SauleVire/Kolektorius_v2a/v1.2/Order#100022604_2Layer_Green_1.6mm_HASL_5cm_x_5cm.TXT

%
M48
M72
T01C0.0120
T02C0.0320
T03C0.0394
T04C0.0400
T05C0.1102
T06C0.1180
T07C0.1181
T08C0.1260
%
T01
X9660Y8633
X13950Y8253
X10000Y15043
X14640Y8623
X13690Y10073
T02
X4600Y7633
X4600Y3633
X5600Y3633
X5600Y7633
X6600Y7633
X6600Y3633
X7600Y7633
X7600Y3633
X2100Y15633
X2600Y14883
X3100Y15633
X12600Y7633
X12600Y11633
X10600Y10633
X10600Y14633
X10850Y17383
X6850Y17383
X6850Y16383
X10850Y16383
X10850Y15383
X6850Y15383
T03
X3100Y16883
X4100Y16883
X5100Y16883
X10600Y19633
X11600Y19633
X12600Y19633
X6600Y19633
X7600Y19633
X8600Y19633
X2600Y19633
X3600Y19633
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
