SauleVire/Kolektorius_v2a/v.2/kolektorius_v2.pdf

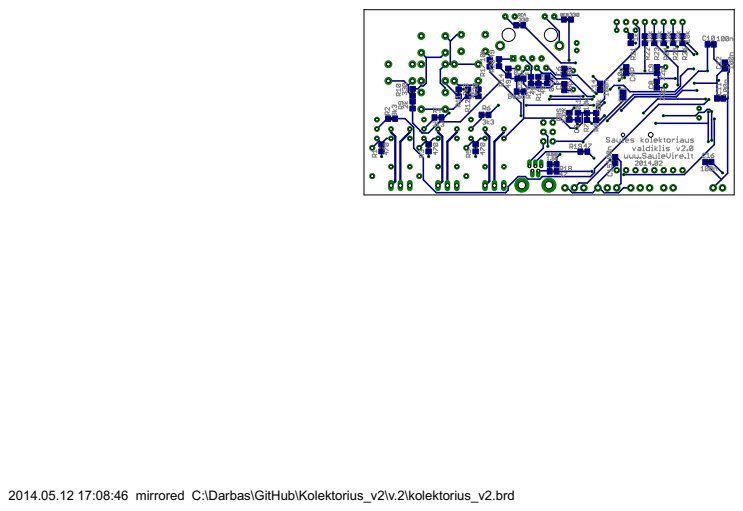
[picture p1: page 1]

2014.05.12 17:08:46 mirrored C:\Darbas\GitHub\Kolektorius_v2\v.2\kolektorius_v2.brd
