SauleVire/Kolektorius_v2a/(list of files, drawings)

Other design files:
skv_v12-arduino-pro-mini-1.fzz
