SauleVire/Kolektorius_v2a/v1.21_hardware/solar_collector_controller_V1.21.brd

## EAGLE design v1.21_hardware/solar_collector_controller_V1.21.brd (2014-10-30)

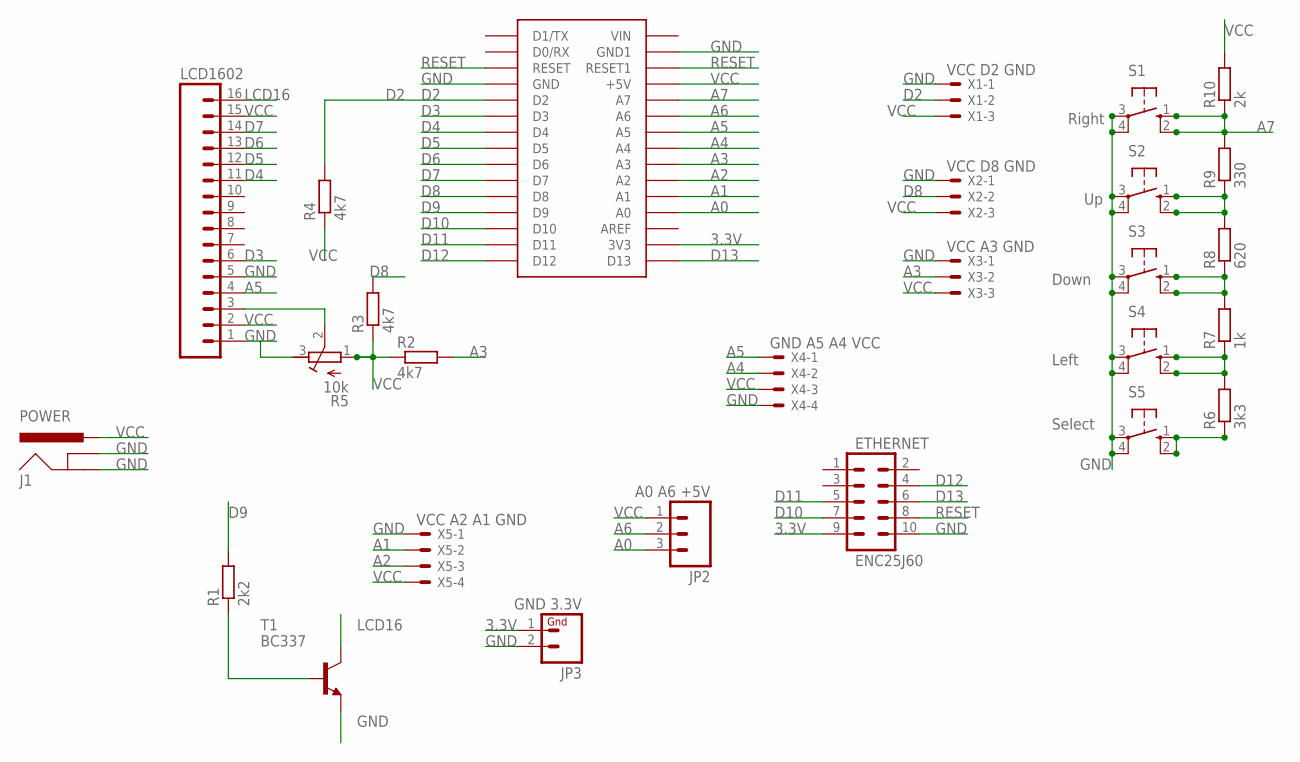
[picture p2: schematic solar_collector_controller_V1.21.sch]

Parts:
ETHERNET: ENC25J60; AVR_ICSP
J1: POWER; POWER_JACK_PTH_LOCK
JP2: A0 A6 +5V; 1X03
JP3: GND 3.3V; 1X02
LCD1602: HEADER-16P-2.54; 16P-2.54
R1: 2k2; 0207/10
R2, R3, R4: 4k7; 0207/10
R5: 10k; RTRIM64W
R6: 3k3; 0207/10
R7: 1k; 0207/10
R8: 620; 0207/10
R9: 330; 0207/10
R10: 2k; 0207/10
S1: Right; B3F-10XX
S2: Up; B3F-10XX
S3: Down; B3F-10XX
S4: Left; B3F-10XX
S5: Select; B3F-10XX
T1: BC337; TO92
U$2: ARDUINONANO; PDIP-32
X1: VCC D2 GND; 22-23-2031
X2: VCC D8 GND; 22-23-2031
X3: VCC A3 GND; 22-23-2031
X4: GND A5 A4 VCC; 22-23-2041
X5: VCC A2 A1 GND; 22-23-2041

Connections:
3.3V: ETHERNET.9, JP3.1, U$2.3V3
A0: JP2.3, U$2.A0
A1: U$2.A1, X5.2
A2: U$2.A2, X5.3
A3: R2.2, U$2.A3, X3.2
A4: U$2.A4, X4.2
A5: LCD1602.4, U$2.A5, X4.1
A6: JP2.2, U$2.A6
A7: R9.2, R10.1, S1.1 (S), S1.2 (S1), U$2.A7
D2: R4.2, U$2.D2, X1.2
D3: LCD1602.6, U$2.D3
D4: LCD1602.11, U$2.D4
D5: LCD1602.12, U$2.D5
D6: LCD1602.13, U$2.D6
D7: LCD1602.14, U$2.D7
D8: R3.2, U$2.D8, X2.2
D9: R1.2, U$2.D9
D10: ETHERNET.7, U$2.D10
D11: ETHERNET.5, U$2.D11
D12: ETHERNET.4, U$2.D12
D13: ETHERNET.6, U$2.D13
GND: ETHERNET.10, J1.GND, J1.GNDBREAK, JP3.2, LCD1602.1, LCD1602.5, R5.3 (A), S1.3, S1.4 (P1), S2.3, S2.4 (P1), S3.3, S3.4 (P1), S4.3, S4.4 (P1), S5.3, S5.4 (P1), T1.1 (E), U$2.GND, U$2.GND1, X1.1, X2.1, X3.1, X4.4, X5.1
LCD16: LCD1602.16, T1.3 (C)
unnamed: LCD1602.3, R5.2 (S)
unnamed: R1.1, T1.2 (B)
unnamed: R6.1, S5.1 (S), S5.2 (S1)
unnamed: R6.2, R7.1, S4.1 (S), S4.2 (S1)
unnamed: R7.2, R8.1, S3.1 (S), S3.2 (S1)
unnamed: R8.2, R9.1, S2.1 (S), S2.2 (S1)
RESET: ETHERNET.8, U$2.RESET, U$2.RESET1
VCC: J1.PWR, JP2.1, LCD1602.2, LCD1602.15, R2.1, R3.1, R4.1, R5.1 (E), R10.2, U$2.+5V, X1.3, X2.3, X3.3, X4.3, X5.4

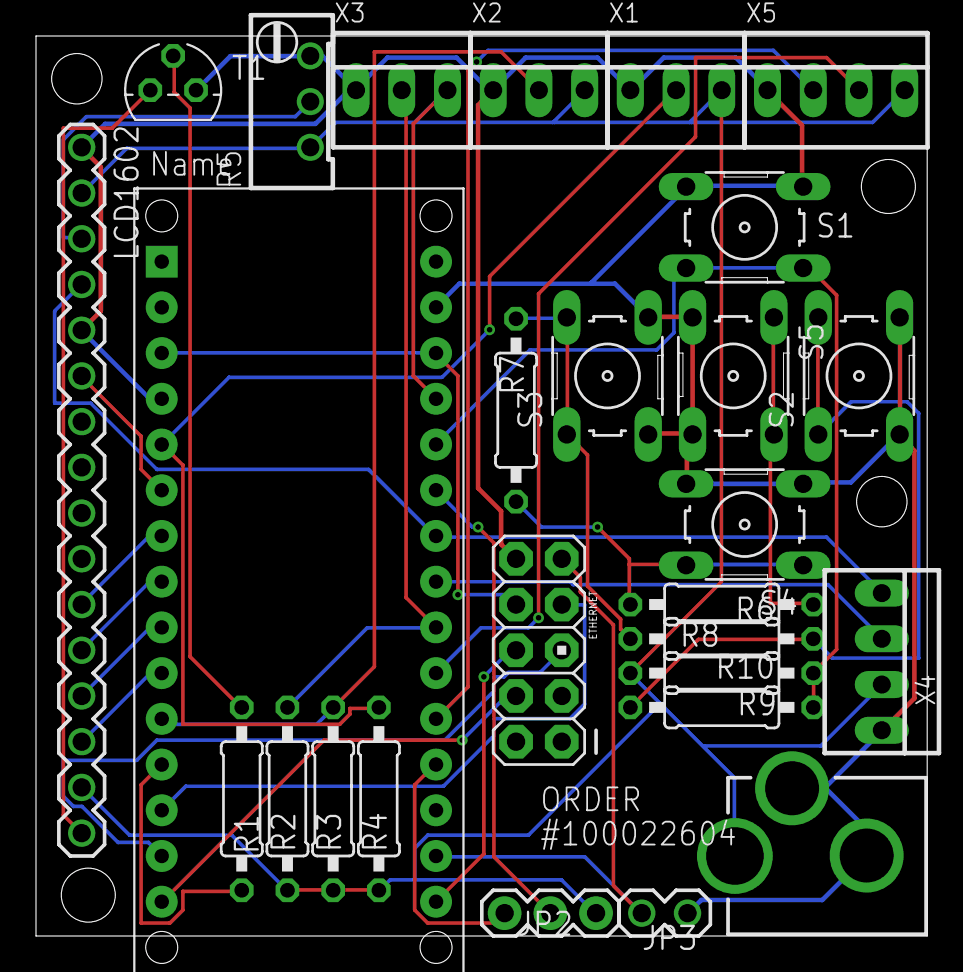
[picture p3: board solar_collector_controller_V1.21.brd from above]

Board: 2 copper layers, 49.5 x 50.0 mm, 27 parts (0 on the bottom side), 31 nets.
