SauleVire/Kolektorius_v2a/v1.2/solar_collector_controller_V2.brd

## EAGLE design v1.2/solar_collector_controller_V2.brd (2014-10-27, an earlier design)

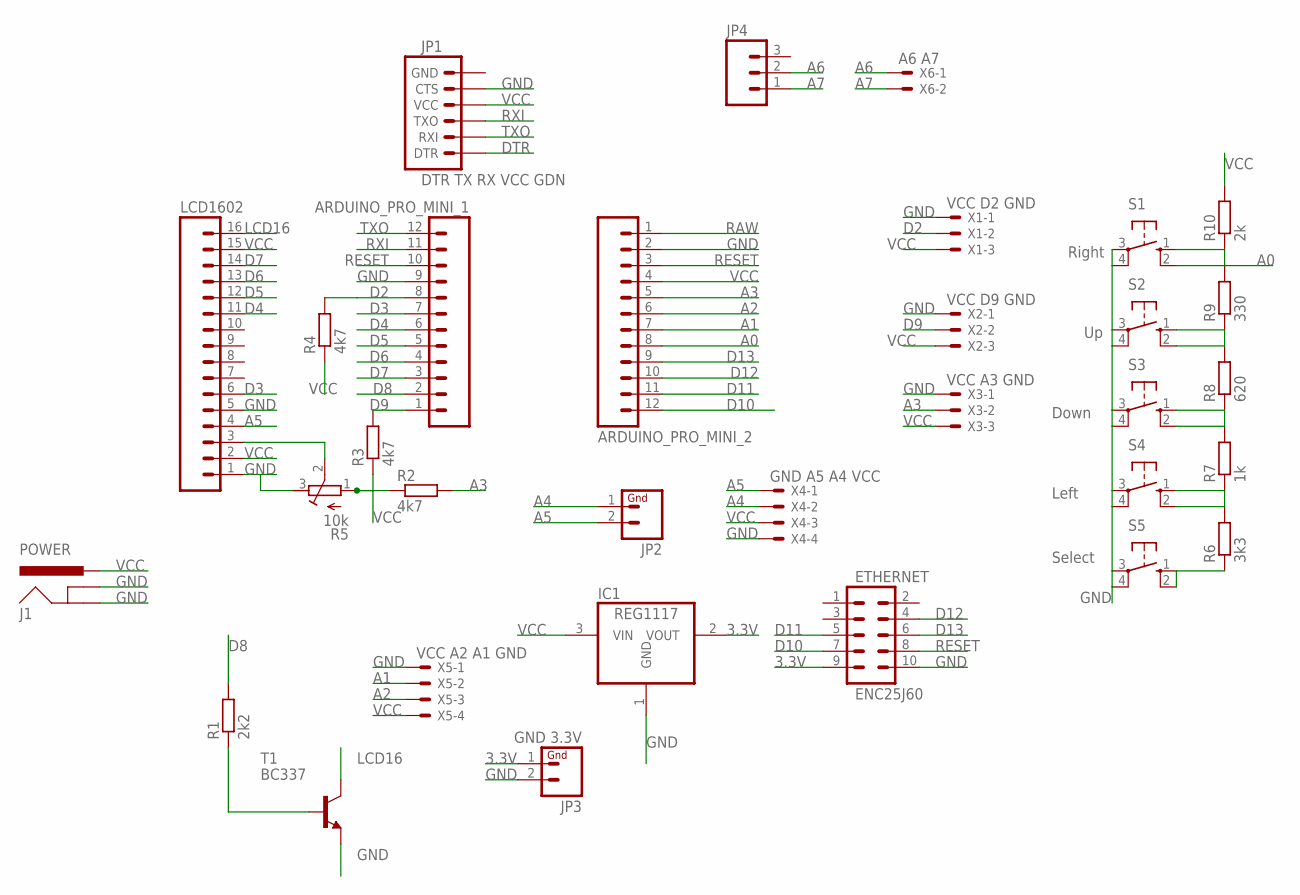
[picture p4: schematic solar_collector_controller_V2.sch]

Parts:
ARDUINO_PRO_MINI_1, ARDUINO_PRO_MINI_2: M12PTH; 1X12
ETHERNET: ENC25J60; AVR_ICSP
IC1: REG1117; SOT223
J1: POWER; POWER_JACK_PTH_LOCK
JP1: DTR TX RX VCC GDN; 1X06
JP2: M02PTH; 1X02
JP3: GND 3.3V; 1X02
JP4: M03PTH; 1X03
LCD1602: HEADER-16P-2.54; 16P-2.54
R1: 2k2; 0207/10
R2, R3, R4: 4k7; 0207/10
R5: 10k; RTRIM64W
R6: 3k3; 0207/10
R7: 1k; 0207/10
R8: 620; 0207/10
R9: 330; 0207/10
R10: 2k; 0207/10
S1: Right; B3F-10XX
S2: Up; B3F-10XX
S3: Down; B3F-10XX
S4: Left; B3F-10XX
S5: Select; B3F-10XX
T1: BC337; TO92
X1: VCC D2 GND; 22-23-2031
X2: VCC D9 GND; 22-23-2031
X3: VCC A3 GND; 22-23-2031
X4: GND A5 A4 VCC; 22-23-2041
X5: VCC A2 A1 GND; 22-23-2041
X6: A6 A7; 22-23-2021

Connections:
3.3V: ETHERNET.9, IC1.2 (VOUT), JP3.1
A0: ARDUINO_PRO_MINI_2.8, R9.2, R10.1, S1.1 (S), S1.2 (S1)
A1: ARDUINO_PRO_MINI_2.7, X5.2
A2: ARDUINO_PRO_MINI_2.6, X5.3
A3: ARDUINO_PRO_MINI_2.5, R2.2, X3.2
A4: JP2.1, X4.2
A5: JP2.2, LCD1602.4, X4.1
A6: JP4.2, X6.1
A7: JP4.1, X6.2
D2: ARDUINO_PRO_MINI_1.8, R4.2, X1.2
D3: ARDUINO_PRO_MINI_1.7, LCD1602.6
D4: ARDUINO_PRO_MINI_1.6, LCD1602.11
D5: ARDUINO_PRO_MINI_1.5, LCD1602.12
D6: ARDUINO_PRO_MINI_1.4, LCD1602.13
D7: ARDUINO_PRO_MINI_1.3, LCD1602.14
D8: ARDUINO_PRO_MINI_1.2, R1.2
D9: ARDUINO_PRO_MINI_1.1, R3.2, X2.2
D10: ARDUINO_PRO_MINI_2.12, ETHERNET.7
D11: ARDUINO_PRO_MINI_2.11, ETHERNET.5
D12: ARDUINO_PRO_MINI_2.10, ETHERNET.4
D13: ARDUINO_PRO_MINI_2.9, ETHERNET.6
DTR: JP1.1 (DTR)
GND: ARDUINO_PRO_MINI_1.9, ARDUINO_PRO_MINI_2.2, ETHERNET.10, IC1.1 (GND), J1.GND, J1.GNDBREAK, JP1.5 (CTS), JP3.2, LCD1602.1, LCD1602.5, R5.3 (A), S1.3, S1.4 (P1), S2.3, S2.4 (P1), S3.3, S3.4 (P1), S4.3, S4.4 (P1), S5.3, S5.4 (P1), T1.1 (E), X1.1, X2.1, X3.1, X4.4, X5.1
LCD16: LCD1602.16, T1.3 (C)
unnamed: LCD1602.3, R5.2 (S)
unnamed: R1.1, T1.2 (B)
unnamed: R6.1, S5.1 (S), S5.2 (S1)
unnamed: R6.2, R7.1, S4.1 (S), S4.2 (S1)
unnamed: R7.2, R8.1, S3.1 (S), S3.2 (S1)
unnamed: R8.2, R9.1, S2.1 (S), S2.2 (S1)
RAW: ARDUINO_PRO_MINI_2.1
RESET: ARDUINO_PRO_MINI_1.10, ARDUINO_PRO_MINI_2.3, ETHERNET.8
RXI: ARDUINO_PRO_MINI_1.11, JP1.3 (TXO)
TXO: ARDUINO_PRO_MINI_1.12, JP1.2 (RXI)
VCC: ARDUINO_PRO_MINI_2.4, IC1.3 (VIN), J1.PWR, JP1.4 (VCC), LCD1602.2, LCD1602.15, R2.1, R3.1, R4.1, R5.1 (E), R10.2, X1.3, X2.3, X3.3, X4.3, X5.4

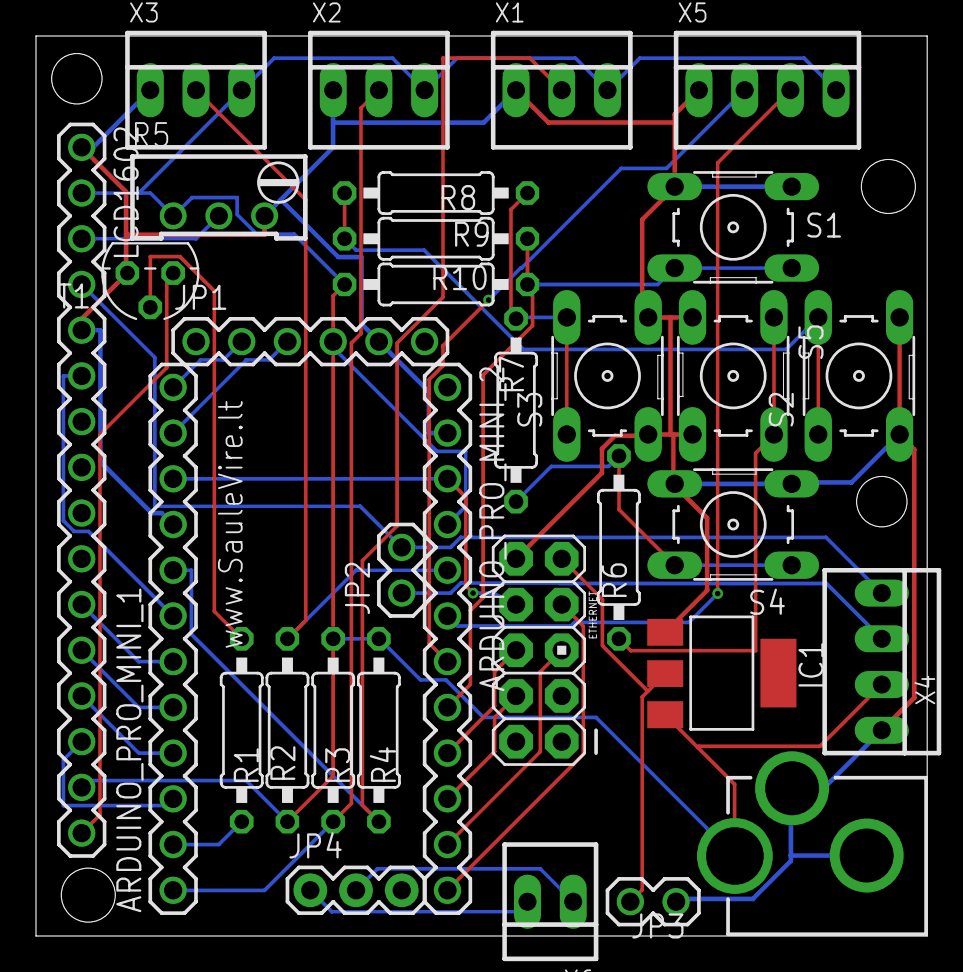
[picture p5: board solar_collector_controller_V2.brd from above]

Board: 2 copper layers, 49.5 x 50.0 mm, 32 parts (0 on the bottom side), 33 nets.
