SauleVire/Kolektorius_v2a/v.2/kolektorius_v21.brd

## EAGLE design v.2/kolektorius_v21.brd (2014-10-27, an earlier design)

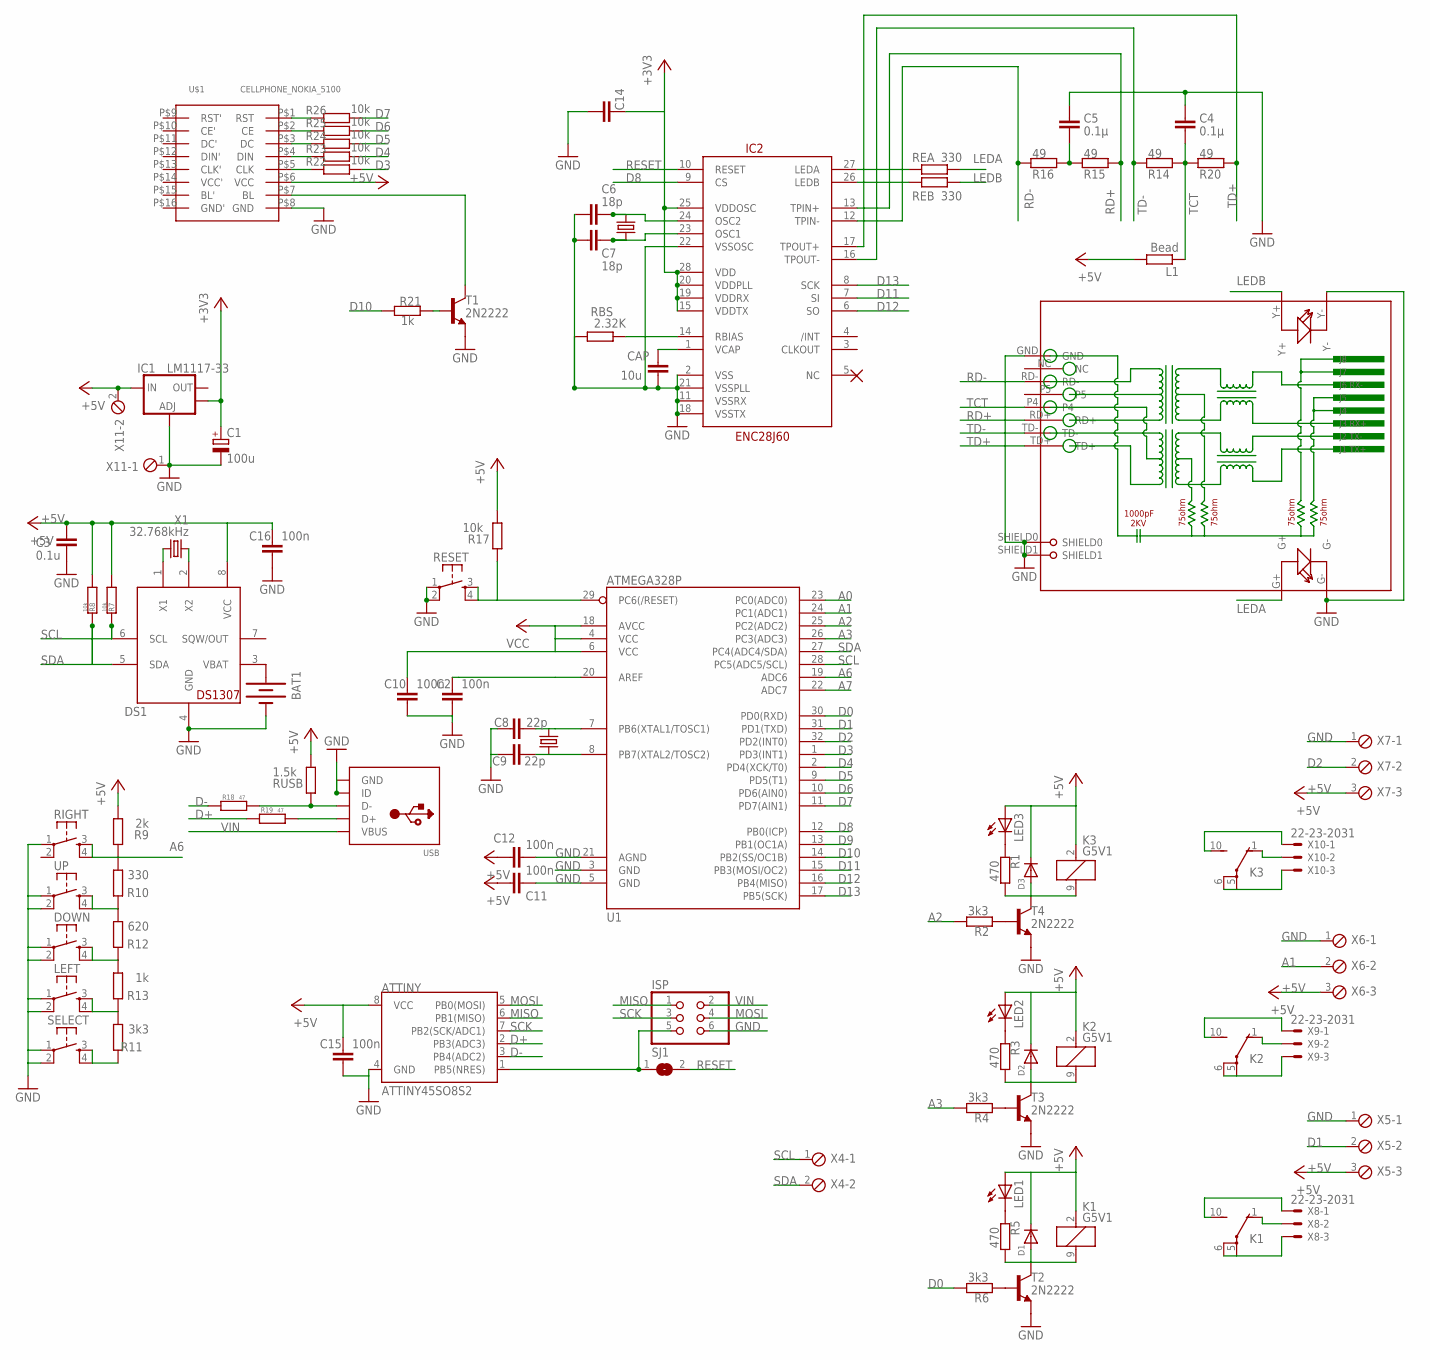
[picture p6: schematic kolektorius_v21.sch]

Parts:
ATTINY: ATTINY45SO8S2; SO8S2
BAT1: BATTERYBATTERY_12MM_SMT; BATTCON_12MM_SMT
C1: 100u; E2-5
C2, C10, C11, C12, C14, C15, C16: 100n; C0805
C3: 0.1u; C0805
C4, C5: 0.1µ; C0805
C6, C7: 18p; C0805
C8, C9: 22p; C0805
CAP: 10u; C0805
D1, D2, D3: DIODEDO-1N4148; DO-1N4148
DOWN: TAC_SWITCHPTH; TACTILE-PTH
DS1: DS1307; SO08
IC1: LM1117-33; SOT223
IC2: ENC28J60; SSOP28DB
ISP: PINHD-2X3; 2X03
K1, K2, K3: G5V1
L1: Bead; R0805
LED1, LED2, LED3: LEDSMT1206; 1206
LEFT: TAC_SWITCHPTH; TACTILE-PTH
R1, R3, R5: 470; R0805
R2, R4, R6, R11: 3k3; R0805
R7, R8, R17, R22, R23, R24, R25, R26: 10k; R0805
R9: 2k; R0805
R10: 330; R0805
R12: 620; R0805
R13, R21: 1k; R0805
R14, R15, R16, R20: 49; R0805
R18, R19: 47; R0805
RBS: 2.32K; R0805
REA: 330; R0805
REB: 330; R0805
RESET: TAC_SWITCHPTH; TACTILE-PTH
RIGHT: TAC_SWITCHPTH; TACTILE-PTH
RJ1: HR911105A
RUSB: 1.5k; R0805
SELECT: TAC_SWITCHPTH; TACTILE-PTH
SJ1: SJ
T1, T2, T3, T4: 2N2222; TO92-EBC-OVAL
U1: ATMEGA328P; TQFP32-08
U$1: CELLPHONE_NOKIA_5100; CELLPHONE_NOKIA_5100_SPARKFUN
UP: TAC_SWITCHPTH; TACTILE-PTH
USB: USBMOLEX; USB-MINIB-THM-MOLEX
X1: 32.768kHz; TC26H
X2: 16MHz; HC49US
X3: 25MHz; HC49US
X4, X11: MPT2; 2POL254
X5, X6, X7: MPT3; 3POL254
X8, X9, X10: 22-23-2031

Connections:
+3V3: C1.+, C14.1, IC1.4 (OUT), IC2.15 (VDDTX), IC2.19 (VDDRX), IC2.20 (VDDPLL), IC2.25 (VDDOSC), IC2.28 (VDD)
+5V: ATTINY.8 (VCC), C3.1, C11.2, C12.2, C15.1, C16.1, D1.C, D2.C, D3.C, DS1.8 (VCC), IC1.3 (IN), K1.2 (1), K2.2 (1), K3.2 (1), L1.2, LED1.A, LED2.A, R7.2, R8.2, U$1.P$6 (VCC), X5.3, X6.3, X7.3, X11.2
A0: U1.23 (PC0(ADC0))
A1: U1.24 (PC1(ADC1)), X6.2
A2: R2.2, U1.25 (PC2(ADC2))
A3: R4.2, U1.26 (PC3(ADC3))
A6: R9.1, R10.2, RIGHT.3, RIGHT.4, U1.19 (ADC6)
A7: U1.22 (ADC7)
D0: R6.2, U1.30 (PD0(RXD))
D1: U1.31 (PD1(TXD)), X5.2
D2: U1.32 (PD2(INT0)), X7.2
D3: R22.2, U1.1 (PD3(INT1))
D4: R23.2, U1.2 (PD4(XCK/T0))
D5: R24.2, U1.9 (PD5(T1))
D6: R25.2, U1.10 (PD6(AIN0))
D7: R26.2, U1.11 (PD7(AIN1))
D8: IC2.9 (CS), U1.12 (PB0(ICP))
D9: U1.13 (PB1(OC1A))
D10: R21.2, U1.14 (PB2(SS/OC1B))
D11: IC2.7 (SI), U1.15 (PB3(MOSI/OC2))
D12: IC2.6 (SO), U1.16 (PB4(MISO))
D13: IC2.8 (SCK), U1.17 (PB5(SCK))
D+: ATTINY.2 (PB3(ADC3)), R19.1
D-: ATTINY.3 (PB4(ADC2)), R18.1
GND: ATTINY.4 (GND), BAT1.P$1 (-), C1.-, C2.2, C3.2, C4.1, C5.1, C6.2, C7.2, C8.1, C9.1, C10.2, C11.1, C12.1, C14.2, C15.2, C16.2, CAP.2, DOWN.1, DOWN.2, DS1.4 (GND), IC1.1 (ADJ), IC2.2 (VSS), IC2.11 (VSSRX), IC2.18 (VSSTX), IC2.21 (VSSPLL), IC2.22 (VSSOSC), ISP.6, LEFT.1, LEFT.2, RBS.1, RESET.1, RESET.2, RIGHT.1, RJ1.G-, RJ1.GND, RJ1.SHIELD0, RJ1.SHIELD1, RJ1.Y-, SELECT.1, SELECT.2, T1.E, T2.E, T3.E, T4.E, U1.3 (GND), U1.5 (GND), U1.21 (AGND), U$1.P$8 (GND), UP.1, UP.2, USB.GND, USB.ID, X5.1, X6.1, X7.1, X11.1
LEDA: REA.2, RJ1.G+
LEDB: REB.2, RJ1.Y+
MISO: ATTINY.6 (PB1(MISO)), ISP.1
MOSI: ATTINY.5 (PB0(MOSI)), ISP.4
unnamed: LEFT.3, LEFT.4, R11.2, R13.1
unnamed: D2.A, K2.9 (2), R3.2, T3.C
unnamed: R4.1, T3.B
unnamed: K2.5, K2.6, X9.3
unnamed: K2.1 (O), X9.2
unnamed: DOWN.3, DOWN.4, R12.1, R13.2
unnamed: LED2.C, R3.1
unnamed: DS1.1 (X1), X1.2
unnamed: R10.1, R12.2, UP.3, UP.4
unnamed: D1.A, K1.9 (2), R5.2, T2.C
unnamed: D3.A, K3.9 (2), R1.2, T4.C
unnamed: R2.1, T4.B
unnamed: K2.10 (S), X9.1
unnamed: K1.10 (S), X8.1
unnamed: K3.10 (S), X10.1
unnamed: R6.1, T2.B
unnamed: R11.1, SELECT.3, SELECT.4
unnamed: K3.5, K3.6, X10.3
unnamed: K3.1 (O), X10.2
unnamed: LED3.C, R1.1
unnamed: R22.1, U$1.P$5 (CLK)
unnamed: R25.1, U$1.P$2 (CE)
unnamed: R24.1, U$1.P$3 (DC)
unnamed: R23.1, U$1.P$4 (DIN)
unnamed: T1.C, U$1.P$7 (BL)
unnamed: K1.5, K1.6, X8.3
unnamed: K1.1 (O), X8.2
unnamed: DS1.2 (X2), X1.1
unnamed: LED1.C, R5.1
unnamed: C9.2, U1.8 (PB7(XTAL2/TOSC2)), X2.1
unnamed: C8.2, U1.7 (PB6(XTAL1/TOSC1)), X2.2
unnamed: IC2.27 (LEDA), REA.1
unnamed: C2.1, U1.20 (AREF)
unnamed: BAT1.P$2 (+), DS1.3 (VBAT)
unnamed: IC2.26 (LEDB), REB.1
unnamed: R19.2, USB.D+
unnamed: CAP.1, IC2.1 (VCAP)
unnamed: C6.1, IC2.24 (OSC2), X3.2
unnamed: C7.1, IC2.23 (OSC1), X3.1
unnamed: R21.1, T1.B
unnamed: R18.2, RUSB.1, USB.D-
unnamed: R17.1, RESET.3, RESET.4, U1.29 (PC6(/RESET))
unnamed: ATTINY.1 (PB5(NRES)), ISP.5, SJ1.1
unnamed: C5.2, R15.1, R16.2
unnamed: IC2.14 (RBIAS), RBS.2
RD+: IC2.13 (TPIN+), R15.2, RJ1.RD+
RD-: IC2.12 (TPIN-), R16.1, RJ1.RD-
RESET: IC2.10 (RESET), SJ1.2
SCK: ATTINY.7 (PB2(SCK/ADC1)), ISP.3
SCL: DS1.6 (SCL), R7.1, U1.28 (PC5(ADC5/SCL))
SDA: DS1.5 (SDA), R8.1, U1.27 (PC4(ADC4/SDA))
TCT: C4.2, L1.1, R14.2, R20.1, RJ1.P4
TD+: IC2.17 (TPOUT+), R20.2, RJ1.TD+
TD-: IC2.16 (TPOUT-), R14.1, RJ1.TD-
V$: R26.1, U$1.P$1 (RST)
VCC: C10.1, R9.2, R17.2, RUSB.2, U1.4 (VCC), U1.6 (VCC), U1.18 (AVCC)
VIN: ISP.2, USB.VBUS

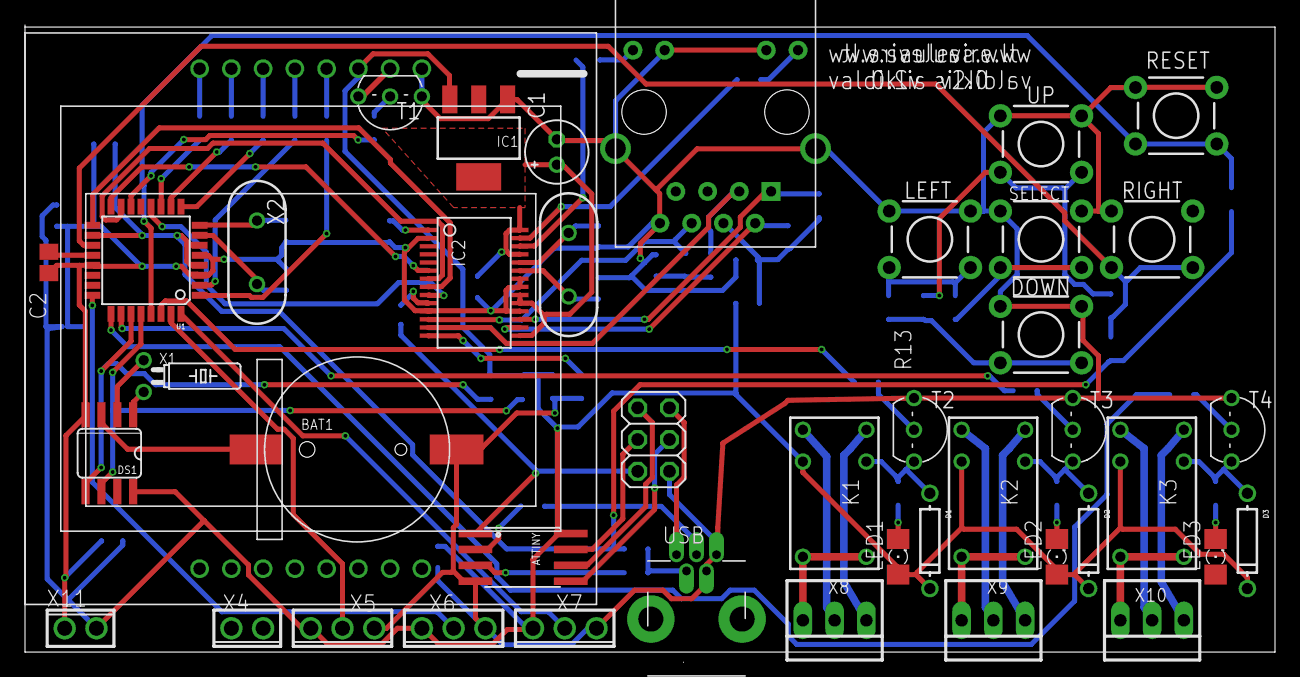
[picture p7: board kolektorius_v21.brd from above]

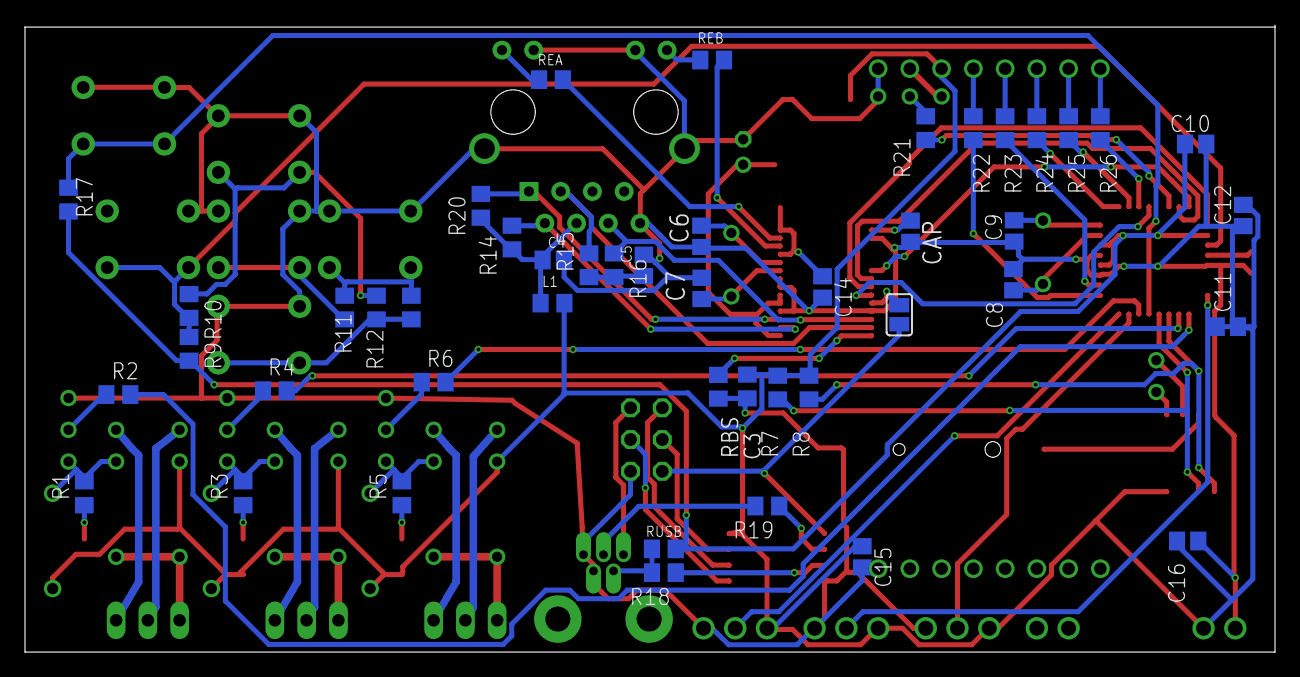
[picture p8: board kolektorius_v21.brd from below]

Board: 2 copper layers, 100.0 x 50.2 mm, 88 parts (46 on the bottom side), 83 nets.
