SauleVire/Kolektorius_v2a/v12_onewire/v12_onewire.ino

// ============= KKK valdinlis v2.1 ===============================================

#include <Wire.h>
 #include <MenuBackend.h>        
  #include <LiquidCrystal.h>         
 #include <OneWire.h>
#include <DallasTemperature.h>
 #include <EEPROM.h>
#include "definitions.h"
#include <EtherCard.h>

#define STATIC 1  // set to 1 to disable DHCP (adjust myip/gwip values below)

#if STATIC
// ethernet interface ip address
static byte myip[] = { 192,168,1,2 };
// gateway ip address
static byte gwip[] = { 192,168,1,254 };
// dns ip address
static byte dnsip[] = { 192,168,1,254 };
#endif

// ethernet mac address - must be unique on your network
static byte mymac[] = { 0x74,0x69,0x69,0x2D,0x30,0x31 };

byte Ethernet::buffer[250]; // tcp/ip send and receive buffer
unsigned long Ethernet_timer;

char website[] PROGMEM = "saulevire.lt";

// This is the char array that holds the reply data
char line_buf[33];
  


uint8_t arrowUpDown[8] = {0x4,0xe,0x15,0x4,0x15,0xe,0x4};
uint8_t arrowDown[8]  = {0x4,0x4,0x4,04,0x15,0xe,0x4};
uint8_t arrowRight[8] = {0x0,0x4,0x2,0x1f,0x2,0x4,0x0};
uint8_t arrowLeft[8] = {0x0,0x4,0x8,0x1f,0x8,0x4,0x0};
uint8_t arrowBack[8] = {0x1,0x1,0x5,0x9,0x1f,0x8,0x4};
uint8_t arrowUp[8]={ B00100,B01110,B11111,B00100,B00100,B00100,B00100,B00100};

LiquidCrystal lcd(A5, 3, 4, 5, 6, 7);
/* ------------------ R T C ---------------------- */


/* --------------------- RTC PABAIGA ---------------- */
char *eilute1;
char *eilute2;
    boolean InMenu = false;

// --- tworzymy wszystkie opcje Menu: ---------------------------------------

MenuBackend menu = MenuBackend(menuUseEvent,menuChangeEvent); // konstruktor 
   //                        ("                ")
   MenuItem P1 =  MenuItem("KOLEKTORIUS   ",1);
      MenuItem P11 = MenuItem("Ijungimo sk. t",2);
      MenuItem P12 = MenuItem("Isjungimo sk.t",2);
      MenuItem P13 = MenuItem("Irasyti nustat",2);
      MenuItem P14 = MenuItem("Nuorinimas    ",2);

   MenuItem P2 = MenuItem("TERMOSTATAS   ",1);
      MenuItem P21 = MenuItem("temperatura 1 ",2);
      MenuItem P22 = MenuItem("temperatura 2 ",2);
      MenuItem P23 = MenuItem("busena        ",2);


/* --- Teraz pozycjonujemy  menu ( zgodnie z ustawieniem podanym powy�ej) ------------
add - dodaje w pionie, addRight - dodaje w poziomie z prawej , addLeft dodaje z lewej
*/
void menuSetup()                       // funkcja klasy MenuBackend 
{
      menu.getRoot().add(P1);          // 
      P1.add(P11);
        P11.add(P12);P11.addLeft(P1);  //  
        P12.add(P13);P12.addLeft(P1);  // 
        P13.add(P14);P13.addLeft(P1);  // 
        P14.add(P11);P14.addLeft(P1);  // 
        
      menu.getRoot().add(P2);
      P1.addRight(P2);                 //
      
      P2.add(P21);                     // 
        P21.add(P22);P21.addLeft(P2);  // 
        P22.add(P23);P22.addLeft(P2);  // 
        P23.add(P21);P23.addLeft(P2);  // 

      menu.getRoot().add(P1);
      P2.addRight(P1);                 //
      
}
// ----------- uff... nareszcie :-) -----------------------------------------------------------------------
void menuUseEvent(MenuUseEvent used)

{
   Serial.print("pasirinkta:  "); Serial.println(used.item.getName());


/* __________________________ NUSTATYMAI Ijungimo skirtumo temperatura          _______________________ */
if (used.item.getName() == "Ijungimo sk. t")   // dokladnie taki sam ciag " Temperatura"
k_ijungimo_skirtumas =  MeniuFunkcija ("Nustatyta=    ", k_ijungimo_skirtumas, 25, 1, ">Temperatura OK");
     ///////////////////////////////////////////////////////////////////
/* __________________________ NUSTATYMAI Isjungimo skirtumo temperatura          _______________________ */     
if (used.item.getName() == "Isjungimo sk.t")   // dokladnie taki sam ciag " Temperatura"
k_isjungimo_skirtumas =  MeniuFunkcija ("Nustatyta=    ", k_isjungimo_skirtumas, 25, 1, ">Temperatura OK"); 
     ///////////////////////////////////////////////////////////////////     
/* __________________________ NUSTATYMAI Irasymas____________________________________ */
     if (used.item.getName() == "Irasyti nustat")
      {
                 SaveConfig();
                 lcd.setCursor(0,0);lcd.print(">Irasyta OK        ");delay(2000); // pokazujemy OK przez 2 sek.
                 lcd.setCursor(0,0);lcd.print("                    ");
                 lcd.setCursor(0,0);lcd.print("*");lcd.print(eilute1);           // odtwarzamy poprzedni stan na LCD
                 lcd.setCursor(15,0);lcd.print("*");
                menu.moveDown();

      }
/* __________________________ Termostatas temperatura 1   _______________________ */
if (used.item.getName() == "temperatura 1 ")   // dokladnie taki sam ciag " Temperatura"
temperatura_1 =  MeniuFunkcija ("Nustatyta=    ", temperatura_1, 99, -25, ">Temperatura OK"); 
     ///////////////////////////////////////////////////////////////////
/* __________________________ Termostatas temperatura 2  _______________________ */     
if (used.item.getName() == "temperatura 2 ")   // dokladnie taki sam ciag " Temperatura"
temperatura_2 =  MeniuFunkcija ("Nustatyta=    ", temperatura_2, 99, -25, ">Temperatura OK"); 
     ///////////////////////////////////////////////////////////////////     
/* __________________________ Termostatas busena  _______________________ */     
if (used.item.getName() == "busena        ") 
 {       
        lcd.setCursor(0,0);lcd.write(7);     
        lcd.setCursor(1,1);lcd.print("Busena-"); 
        if (T_busena == 1) lcd.print("sildymas");
        if (T_busena == 2) lcd.print("saldymas");
        if (T_busena == 3) lcd.print("isjungta");
//      lcd.print(Busena(T_busena,termostato_busenos_pavadinimas));
        int  veiksmas=-1; delay(1000);         // 
                                           
        while(veiksmas!=4)                   // 
         {
           klaviaturos_pasikeitimas=-1; 
           veiksmas=Klaviaturos_skaitymas(Key_Pin); //delay(300);  
                                            
           if(klaviaturos_pasikeitimas!=veiksmas)           
             {
             if (veiksmas==1) {T_busena++; if(T_busena>3) T_busena=1; 
                                                 lcd.setCursor(8,1); 
                                               //  lcd.print(Busena(T_busena,termostato_busenos_pavadinimas));
                                                 if (T_busena == 1) lcd.print("sildymas");
                                                 if (T_busena == 2) lcd.print("saldymas");
                                                 if (T_busena == 3) lcd.print("isjungta"); 
                                            delay(200);}
             if(veiksmas==2)  {T_busena--; if(T_busena<1) T_busena=3; 
                                                 lcd.setCursor(8,1); 
                                              //   lcd.print(Busena(T_busena,termostato_busenos_pavadinimas));
                                                 if (T_busena == 1) lcd.print("sildymas");
                                                 if (T_busena == 2) lcd.print("saldymas");
                                                 if (T_busena == 3) lcd.print("isjungta"); 
                                               delay(200);}
             if(veiksmas==4) // 0
               {
                 lcd.setCursor(0,0); lcd.print("Busena        OK"); delay(2000); // 0
                 lcd.setCursor(0,0); lcd.print("                "); // 0
                 lcd.setCursor(1,0);lcd.print(eilute1);           // 0
                 menu.moveDown();
               }
             } 
         } klaviaturos_pasikeitimas=veiksmas;
 }
 
}

void menuChangeEvent(MenuChangeEvent changed)  // funkcja klasy MenuBackend 
{
  if(changed.to.getName()==menu.getRoot())
  {
    InMenu =false;
    Serial.println("Dabar esame MenuRoot");
    LCD_T_sablonas();
    Temperaturu_vaizdavimas();
  }
  /* tak naprawd� to tylko tutaj przydaje si� �w shortkey i s�u�y przede wszystkim do wzbogacenia menu
     o symbole strza�ek w zale�no�ci co wybrano. Wszystko co tutaj si� wyprawia jest pokazywane na LCD.
  */
  int c=changed.to.getShortkey();                         // pobieramy shortkey (1,2,3, lub4)
  lcd.clear();                                            // bez komentarza 
  lcd.setCursor(0,0); 
  if(c==1)                                                // jeśli to menu głowne (shortkey=1) to:
    {InMenu =true;
    lcd.write(3);                                         // strzałka w lewo
    strcpy(eilute1,changed.to.getName());                  // tworzymy napis w pierwszej linii
    lcd.print(eilute1);                                    // wyświetlamy ją
    lcd.setCursor(15,0);lcd.write(4);                     // strzałka w prawo
    lcd.setCursor(0,1);lcd.write(5);                      // strzałka w dół
    lcd.setCursor(15,1);lcd.write(5);                     // strzałka w dół
    }
    if(c==2)                                              // jeśli to podmenu dla dziecka - (shortkey=2) to:
    {InMenu =true;
    lcd.print("*");                                       // rysujemy gwiazdkę
    strcpy(eilute2,changed.to.getName());                  // tworzymy napis w pierwszej linii
    lcd.print(eilute1);                                    // wyświetlamy ją
    lcd.setCursor(15,0);lcd.print("*");                   // gwiazdka 
    lcd.setCursor(0,1);lcd.write(6);                      // druga linia i strzałka powrotu (arrowBack)
    lcd.print(changed.to.getName());                      // wyświetlamy nazwe "dziecka"
    lcd.setCursor(15,1);lcd.write(7);                     // strzałka góra-dół
    }
    if(c==3)                                              // jeśli dziecko  ma dziecko - (shortkey =3) to:
    {InMenu =true;
    lcd.print("*");                                       // gwiazdka
    strcpy(eilute2,changed.to.getName());                  // kopiujemy akt. nazwe opcji menu do zmiennej linia2
    lcd.print(eilute1);                                    // i wyświetlamy pierwszą linię
    lcd.setCursor(15,0);lcd.print("*");                   // gwiazdka
    lcd.setCursor(0,1);lcd.write(6);                      // druga linia i strzałka arrowBack
    lcd.print(changed.to.getName());                      // wyświetlamy wnuka w drugiej linii
    lcd.setCursor(15,1);lcd.write(4);                     // strzałka w prawo bo są wnuki
    }
    
    if(c==4)                                              // jeśli to wnuk  (shortkey =4) to:
    {InMenu =true;
    lcd.print("*");                                       // gwaizdka
    lcd.print(eilute2);                                    // w pierwszej linii wyświetlamy dziecko ( czyli rodzica wnuka) 
    lcd.setCursor(15,0);lcd.print("*");                   // gwaizdka
    lcd.setCursor(0,1);lcd.write(6);                      // druga linia i strzałka arrowBack
    lcd.print(changed.to.getName());                      // wyświetlamy wnuka
    lcd.setCursor(15,1);lcd.write(7);                     // strzałka góra-dół 
    } 
}


volatile int Klaviaturos_skaitymas(int analog)
{
   int stan_Analog = analogRead(analog);delay(30);//Serial.println(stan_Analog); 
   if (stan_Analog > 1000) return -1; // riba
   if (stan_Analog < 50)   return 3;
   if (stan_Analog < 200)  return 1;
   if (stan_Analog < 400)  return 2;
   if (stan_Analog < 600)  return 0;
   if (stan_Analog < 800)  return 4;  // OK 
   return -1;                         // Nepaspaustas
}


// ============================================================================================
// 
void setup()
{
#ifdef DEBUGds18b20                        
  Serial.begin(9600);   
#endif
  /* ********************************************************* */
 LoadConfig(); 
  /* ********************************************************* */
  if (ether.begin(sizeof Ethernet::buffer, mymac,10) == 0) 
    Serial.println( "Failed to access Ethernet controller");
#if STATIC
  ether.staticSetup(myip, gwip, dnsip);
#else
  if (!ether.dhcpSetup())
    Serial.println("DHCP failed");
#endif
  ether.printIp("IP:  ", ether.myip);
  ether.printIp("GW:  ", ether.gwip);  
  ether.printIp("DNS: ", ether.dnsip);  

  if (!ether.dnsLookup(website))
    Serial.println("DNS failed");
    
  ether.printIp("SRV: ", ether.hisip);
  /* ********************************************************* */

  pinMode(BackLight_Pin, OUTPUT);
    digitalWrite(BackLight_Pin,HIGH);
  eilute1=new char[20]; 
  eilute2=new char[20];

  lcd.begin(16, 2);    
  lcd.clear();



  lcd.createChar(3,arrowLeft);
  lcd.createChar(4,arrowRight);
  lcd.createChar(5,arrowDown);
  lcd.createChar(6,arrowBack);
  lcd.createChar(7,arrowUpDown);
  lcd.createChar(1,arrowUp);
    lcd.setCursor(0,0); 
    lcd.print("www.SauleVire.lt");
    lcd.setCursor(0,1); 
    lcd.print("      v1.2"); delay(2999);
 lcd.clear();
  // K_sensor.begin();B_sensor.begin(); T_sensor.begin();
   
  pinMode(13,OUTPUT);digitalWrite(13,LOW); // tik testas 
  pinMode(Rele_K,OUTPUT);pinMode(Rele_T,OUTPUT);
  digitalWrite(Rele_K,HIGH);digitalWrite(Rele_T,HIGH);
  menuSetup(); 
//  menu.moveUp();      


  dallas(ONE_WIRE_BUS1);
  dallas(ONE_WIRE_BUS2);
  dallas(ONE_WIRE_BUS3);

 
  LCD_T_sablonas();
  Temperaturu_vaizdavimas();
    Ekrano_pasvietimo_ijungimo_laikas = millis();
    temperaturu_matavimo_laikas_1 = millis();


  }  // setup() ...************ PABAIGA **************...
  // ************************ PROGRAMOS PRADZIA void loop() *******************************
void loop()    
{


      if (millis()- Ekrano_pasvietimo_ijungimo_laikas > Ekrano_pasvietimo_pertrauka) { 
      analogWrite(BackLight_Pin, 0);
      Backlighting = false;
      Ekrano_pasvietimo_ijungimo_laikas = millis();}

if ((x != -1) && (Backlighting == false)){ analogWrite(BackLight_Pin,lcd_pasvietimas*25);
                                            Backlighting = true;}

//if ((x != -1) && (InMenu == true))Meniu_praleistas_neaktyvus_laikas = millis();
//    else {if (millis()- Meniu_praleistas_neaktyvus_laikas > neaktyvus_meniu)
//          menu.toRoot();
//}
  x=Klaviaturos_skaitymas(Key_Pin);delay(30);             // odczytujemy stan klawiatury:
  if(klaviaturos_pasikeitimas!=x)
    {
      switch(x)                           // sprawdzamy co nacisnieto 
      {
      case 0: menu.moveRight();break;
      case 1: menu.moveUp();break;
      case 2: menu.moveDown();break;
      case 3: menu.moveLeft();break;      // menu w lewo
      case 4: menu.use();break;


      }
    } klaviaturos_pasikeitimas=x;



if (InMenu == false){
  // laiko intervalas naudojamas LCD vaizdui atnaujinti
  if (millis() > Ekrano_rodmenu_atnaujinimo_laikas ) { 
  Ekrano_rodmenu_atnaujinimo_laikas = millis() + Ekrano_rodmenu_atnaujinimo_pertrauka;
  LCD_T_sablonas();
  Temperaturu_vaizdavimas();

  //#ifdef DEBUGds18b20
//Serial.println("Temperaturu_matavimas");
//unsigned long start = millis();
//#endif
  
#ifdef DEBUGds18b20
//unsigned long stop = millis();
//Serial.print("Temperaturu matavimo laikas: ");  Serial.println(stop - start);
Serial.print("K/ ");Serial.print(K);Serial.print(" B/ ");Serial.print(B);Serial.print(" T/ ");Serial.println(T);
Serial.println("----");
Serial.print("T_busena- ");Serial.println(T_busena);
Serial.print("temperatura_1- ");Serial.println(temperatura_1);
Serial.print("temperatura_2- ");Serial.println(temperatura_2);

Serial.println("----");
Serial.print("k_ijungimo_skirtumas- ");Serial.print(k_ijungimo_skirtumas);
Serial.print("  k_isjungimo_skirtumas- ");Serial.println(k_isjungimo_skirtumas);

Serial.print("millis- ");Serial.println(millis()/1000);
#endif
  }
} 



/* +++++++++++++++++++++++++++ PIRMAS LYGIS ++++++++++++++++++++++++++++++++++++ */ 
if (millis() > temperaturu_matavimo_laikas_1 ) { 
  temperaturu_matavimo_laikas_1 = millis() + temperaturu_matavimo_pertrauka_1;
K=    dallas(ONE_WIRE_BUS1);
B=    dallas(ONE_WIRE_BUS2);
T=    dallas(ONE_WIRE_BUS3);
#ifdef DEBUGds18b20
Serial.print("K= ");Serial.println(K);
Serial.print("B= ");Serial.println(B);
Serial.print("T= ");Serial.println(T);
#endif

}
     

ether.packetLoop(ether.packetReceive());
  if ((millis()-Ethernet_timer)>5000) {
    Ethernet_timer = millis();
    Serial.println("Request sent");
/*    strcpy(str,"/input/post?apikey=5f95184d8faf89cfe4ea1e0fd9aad868&json={");                //URL
 //   str[0]='\0';
 //   srtJSON(str);                                   //Start JSON
    addJSON(str,"b",B);       //JSON line 1 - add more lines as needed
    addJSON(str,"k",K);    //JSON line 2 - add more lines as needed 
    endJSON(str);
    Serial.println(str);
    Serial.println(strlen(str));
    // Make our request - here we ask for the emoncms feed value
    // Emoncms.org account example username: switch, password: switch
//    ether.browseUrl(PSTR("/feed/value.json?apikey=4defc9b6fef3aec2aecb538638b471c4&id=8656"),"", website, my_callback);
//ether.browseUrl(PSTR("/input/post?apikey=5f95184d8faf89cfe4ea1e0fd9aad868&json="),"str", website, my_callback);
//ether.browseUrl(PSTR("/input/post?apikey=5f95184d8faf89cfe4ea1e0fd9aad868&json="),"str", website, my_callback);
ether.browseUrl(PSTR(""),"str", website, my_callback);
//  }
*/

char string_temp1[5];
dtostrf(K, 2, 2, string_temp1);
char string_temp2[5];
dtostrf(B, 2, 2, string_temp2);

Stash stash;
byte K_t = stash.create();
stash.print(string_temp1);
//stash.save();
//Stash stash;
byte B_t = stash.create();
stash.print(string_temp2);
stash.save();

Stash::prepare(PSTR("GET /emoncms/input/post?apikey=fc315a15e2f18c816cae67d172947bd8&json={boileris:$H,kolektorius:$H} HTTP/1.0" "\r\n"
    "Host: $F" "\r\n" "\r\n"),
    B_t, K_t, website, my_callback);
 ether.tcpSend();

}
//------------------ kolektoriaus siurblio ir termostato valdymas-----------------------//
if (millis() > Reliu_junginejimo_laikas ) 
 {
   Reliu_junginejimo_laikas=millis()+Reliu_junginejimo_pertrauka;
   if (K-B>=k_ijungimo_skirtumas) digitalWrite(Rele_K,LOW);
   if (K-B<=k_isjungimo_skirtumas) digitalWrite(Rele_K,HIGH);
   
  if (T_busena == 1) 
   {//Jei šildymo režimas (T_busena = 1)
    if (T <= temperatura_1) digitalWrite(Rele_T,LOW);
    if (T >= temperatura_2) digitalWrite(Rele_T,HIGH);
   }
   if (T_busena == 2) 
    {//Jei šaldymo režimas (T_busena = 2)
     if (T >= temperatura_1) digitalWrite(Rele_T,LOW);
     if (T <= temperatura_2) digitalWrite(Rele_T,HIGH);
    }
    if (T_busena == 3) 
     {//Jei antra rele nereikalinga- režimas išjungta
      digitalWrite(Rele_T,HIGH);
     }
 }
}// === PABAIGA ===========================================================
