SauleVire/Kolektorius_v2a/(commit log)

2014-10-27 arduino nano ch340
    [Order#100022604_2Layer_Green_1.6mm_HASL_5cm_x_5cm.GBL, Order#100022604_2Layer_Green_1.6mm_HASL_5cm_x_5cm.GBO, Order#100022604_2Layer_Green_1.6mm_HASL_5cm_x_5cm.GBP, Order#100022604_2Layer_Green_1.6mm_HASL_5cm_x_5cm.GBS, Order#100022604_2Layer_Green_1.6mm_HASL_5cm_x_5cm.GTL, Order#100022604_2Layer_Green_1.6mm_HASL_5cm_x_5cm.GTO, Order#100022604_2Layer_Green_1.6mm_HASL_5cm_x_5cm.GTP, Order#10002260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]
2014-10-30 versija 1.21
    [solar_collector_controller_V1.21.brd, solar_collector_controller_V1.21.sch]
